Leemhuis01/AM-FM-modulator-met-ESP32/README.md

English below

verkoop/sale: https://github.com/Leemhuis01/Products
# AM/FM Modulator 
Dit zijn de bestanden die bij een AM/FM modulator van Otto Tuil horen.
Oorspronkelijk besproken in: https://www.transistorforum.nl/forum/index.php?id=77783

# AM/FM Modulator ENG
These are the files that belong to an AM/FM modulator by Otto Tuil.
Originally discussed at: https://www.transistorforum.nl/forum/index.php?id=77783
