Leemhuis01/AM-FM-modulator-met-ESP32/Onderdelen lijst AM-FM station met linkjes.xlsx

 |  |  |  |  |  |  | €57.94
Item | Qty | Reference(s) | Value | DNP | Footprint / Type
1 | 3 | C1, C40, C41 | 220 µF/25V |  | Electrolytic cap, D 8mm, pitch 3.5 mm | €2.20 | TA-P 220U 35-2: Elko, radiaal, 220 µF, 35 V, RM 3,5, 135 °C, 2000 uur, 20% bei reichelt elektronik (https://www.reichelt.nl/nl/nl/elko-radiaal-220-f-35-v-rm-3-5-135-c-2000-uur-20--ta-p-220u-35-2-p228402.html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)
2 | 2 | C2, C52 | 100n | DNP | Ceramic disc, pitch 5 mm
3 | 1 | C3 | 100p |  | Ceramic disc, pitch 2.5 mm
4 | 3 | C4, C54, C55 | 100n |  | MKT, pitch 5 mm | €10.00
5 | 2 | C5, C25 | 47p |  | Ceramic disc, pitch 2.5 mm
6 | 1 | C6 | 27p |  | Ceramic disc, pitch 2.5 mm
7 | 1 | C7 | 470n |  | MKT, pitch 5 mm
8 | 15 | C8, C9, C10, C11, C12, C13, C19, C27, C28, C29, C36, C37, C38, C39, C48 | 100n |  | Ceramic disc, pitch 5 mm
9 | 1 | C14 | 2n2 |  | MKT, pitch 5 mm
10 | 1 | C15 | 10 µF |  | Electrolytic cap, D 6.3mm, pitch 2.5 mm | €0.21 | Artikelnummer: GA-A 10U 25 (https://www.reichelt.nl/nl/nl/elko-radiaal-10-f-25-v-rm-1-5-105-c-1000-uur-20--ga-a-10u-25-p228364.html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)
11 | 1 | C16 | 10n |  | MKT, pitch 5 mm
12 | 1 | C17 | 120p |  | -
13 | 1 | C18 | 100 µF |  | Electrolytic cap, D 8mm, pitch 3.5 mm | €0.34 | Artikelnummer: GA-A 100U 16 (https://www.reichelt.nl/nl/nl/elko-radiaal-100-f-16-v-rm-2-5-105-c-1000-uur-20--ga-a-100u-16-p228361.html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)
14 | 2 | C20, C22 | 1n |  | MKT, pitch 5 mm
15 | 2 | C21, C23 | 470p |  | MKT, pitch 5 mm
16 | 1 | C24 | 10n |  | Ceramic disc, pitch 2.5 mm
17 | 3 | C26, C46, C47 | 15p |  | Ceramic disc, pitch 2.5 mm
18 | 4 | C30, C31, C32, C33 | 22n |  | MKT, pitch 5 mm
19 | 1 | C34 | 120p | DNP | -
20 | 1 | C35 | 142+59 pF |  | Variable capacitor type 223P |  | https://nl.aliexpress.com/item/32887319637.html?mp=1
21 | 1 | C42 | 1000 µF/35V |  | Electrolytic cap, D 13mm, pitch 5 mm | €0.70 | Artikelnummer: NHG-A 1,0M 35 (https://www.reichelt.nl/nl/nl/elco-radiaal-1-0-mf-35-v-105-c-nhg-a-1-0m-35-p200396.html?trstct=pos_0&nbc=1)
22 | 1 | C43 | 2200 µF/16V |  | Electrolytic cap, D 13mm, pitch 5 mm | €0.93 | NHG-A 2,2M 16: Elco radiaal, 2,2 mF, 16 V, 105°C bei reichelt elektronik (https://www.reichelt.nl/nl/nl/elco-radiaal-2-2-mf-16-v-105-c-nhg-a-2-2m-16-p200402.html?trstct=pos_0&nbc=1)
23 | 2 | C44, C45 | 4n7/Y1 |  | Ceramic disc pitch 10 mm
24 | 3 | C49, C50, C51 | 10n | DNP | Ceramic disc, pitch 2.5 mm
25 | 1 | C53 | 10u | DNP | Electrolytic cap, D 6.3mm, pitch 2.5 mm
26 | 1 | C58 | 4p7 |  | Ceramic disc, pitch 2.5 mm
27 | 2 | C59, C60 | 220p |  | Ceramic disc, pitch 2.5 mm
28 | 1 | D1 | Bridge rectifier 1A |  | DIL 4 | €0.80 | B80D DIO: Bruggelijkrichter, 160 V, 1 A bei reichelt elektronik (https://www.reichelt.nl/nl/nl/bruggelijkrichter-160-v-1-a-b80d-dio-p216814.html?&trstct=pos_2&nbc=1)
29 | 2 | D2, D3 | 1N4001 |  | - | €0.07 | 1N 4001: Gelijkrichterdiode, DO41, 50V, 1A bei reichelt elektronik (https://www.reichelt.nl/nl/nl/gelijkrichterdiode-do41-50v-1a-1n-4001-p1723.html?&trstct=pos_0&nbc=1)
30 | 2 | D4, D5 | BAT85 |  | DO-35/SOD27 | €0.08 | BAT 85: Schottky Diode, DO35, 30V, 0,2A bei reichelt elektronik (https://www.reichelt.nl/nl/nl/schottky-diode-do35-30v-0-2a-bat-85-p4857.html?search=BAT85&&r=1)
31 | 1 | E1 | ANTENNA | DNP | Telescopic antenna
32 | 4 | H1, H2, H3, H4 | MountingHole | DNP | n.a.
33 | 1 | J1 | 230V~ |  | IEC 60320 C8 AC Power Socket 2 pin PCB Mount | €3.16 | Hot Selling Elektrische Socket Iec 320 C8 Power Connector BX-180-H 2 Pin Industriële Socket Uitstekende Kwaliteit Zwart (aliexpress.com) (https://nl.aliexpress.com/item/1005002713381045.html)
34 | 1 | J2 | Conn_01x03 | DNP | PinHeader 2.54mm male | €0.25 | SL 1X36G 2,54: 36-polig Pin header, recht, RM 2,54 bei reichelt elektronik (https://www.reichelt.nl/nl/nl/36-polig-pin-header-recht-rm-2-54-sl-1x36g-2-54-p19504.html?trstct=pos_3&nbc=1)
35 | 2 | J4, J5 | Keystone 900 |  | Keystone RCA ot similar | €2.66 | 10Pcs Wit/Geel/Rood Rca Av Met De Core Socket Gat Zetel 2 Pin Pcb Solderen Audio video Jack Lotusbloemzetel AV1-8.4-3B - AliExpress (https://nl.aliexpress.com/item/32872668581.html)
36 | 3 | JP1, JP7, JP9 | SolderJumper_3_Bridged12 | DNP | -
37 | 1 | JP2 | LSEL |  | PinHeader 2.54mm male
38 | 1 | JP3 | SolderJumper_3_Bridged12 | DNP | -
39 | 4 | JP4, JP5, JP6, JP8 | SolderJumper_3_Bridged12 | DNP | -
40 | 2 | L1, L2 | 330 µH |  | Axial | €1.22 | L-XHBCC 330µ: Vaste inductie, axiaal, XHBCC, ferriet, 330 µH bei reichelt elektronik (https://www.reichelt.nl/nl/nl/vaste-inductie-axiaal-xhbcc-ferriet-330-h-l-xhbcc-330--p138551.html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)
41 | 2 | L3, L4 | 180 µH |  | Axial | €2.00 | L-09HCP 180µ: Staande inductie, 09HCP, ferriet, 180 µH bei reichelt elektronik (https://www.reichelt.nl/nl/nl/staande-inductie-09hcp-ferriet-180-h-l-09hcp-180--p138652.html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)
42 | 1 | L5 | 120nH | DNP | SMD 0805 | €0.31 | L-0805AS 120N: SMD-inductiespoel, 0805, keramiek, 120 nH bei reichelt elektronik (https://www.reichelt.nl/nl/nl/smd-inductiespoel-0805-keramiek-120-nh-l-0805as-120n-p255491.html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)
43 | 1 | M1 | ESP32-WROVER-CAM |  | Placed on 2 PinHeaders 2.54mm female 20 positions | €6.36 | 2022 Nieuwste Esp32 Cam Camera Module ESP32-WROVER Bord Met Camera Wi-Fi Bluetooth Module Voor Arduino Ide C Python Code Ov2640 - AliExpress (https://nl.aliexpress.com/item/1005006198660279.html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)
44 | 1 | M2 | µSD CARD MODULE |  | Soldered on PinHeader 2.54mm male | €2.40 | Tzt Micro Sd Opslag Uitbreidingskaart Mini Micro Sd Tf Kaart Geheugenschild Module Met Pinnen Voor Arduino - AliExpress (https://nl.aliexpress.com/item/32867572635.html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)
45 | 1 | M3 | ELECHOUSE FM TRANSMITTER V2.0 | DNP | Soldered on PinHeaders 2.54mm male | €2.35 | 5 Stks/partij KT0803 KT0803L Sop-16 Fm Stereo Lancering Chip - AliExpress (https://nl.aliexpress.com/item/32828673835.html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)
46 | 1 | M4 | OLED-27X27MM |  | Including PinHeader 2.54mm male | €2.50 | 0.96 Inch Oled Ssd1306 Wit/Blauw/Geel 128X64 Iic I2c Seriële Weergavemodule 12864 Lcd-Schermbord Voor Arduino (aliexpress.com) (https://nl.aliexpress.com/item/1005005970901119.html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)
47 | 1 | M5 | Hi-Link HLK-5M15 | DNP | -
48 | 1 | M6 | CN3903 5V/3A Module | DNP | -
49 | 3 | Q1, Q2, Q3 | 2N7000 |  | TO-92 | €0.75 | https://www.reichelt.nl/nl/nl/mosfet-n-ch-60-v-0-115-a-0-4-w-to-92-2n-7000-fai-p219076.html?trstct=pos_1&nbc=1
50 | 12 | R1, R2, R3, R4, R5, R27, R30, R39, R41, R42, R43, R44 | 10k |  | Axial 1/4 watt
51 | 1 | R6 | 100k | DNP | Axial 1/4 watt
52 | 2 | R7, R8 | 10k | DNP | Axial 1/4 watt
53 | 1 | R10 | 10R |  | Axial 1/4 watt
54 | 6 | R12, R13, R14, R15, R35, R36 | 7k5 |  | Axial 1/4 watt
55 | 4 | R16, R17, R18, R31 | 30k |  | Axial 1/4 watt
56 | 1 | R19 | 220K |  | Axial 1/4 watt
57 | 2 | R20, R21 | 1M |  | Axial 1/4 watt
58 | 1 | R22 | 2K2 |  | Axial 1/4 watt
59 | 1 | R23 | 100K |  | Axial 1/4 watt
60 | 1 | R24 | 3K3 |  | Axial 1/4 watt
61 | 1 | R25 | 2M2 |  | Axial 1/4 watt
62 | 1 | R26 | 5K6 |  | Axial 1/4 watt
63 | 3 | R28, R29, R40 | 220R |  | Axial 1/4 watt
64 | 1 | R32 | 8k2 |  | Axial 1/4 watt
65 | 2 | R33, R34 | 4K7 |  | Axial 1/4 watt
66 | 1 | R37 | 15k |  | Axial 1/4 watt
67 | 1 | R46 | 10R | DNP | Axial 1/4 watt
68 | 3 | SH1, SH2, SH3 | Shield |  | n.a. | €2.00 | Tactiele drukknopschakelaars met schakelaar 6x6x10 | 6x6x13mm tactiele drukknopschakelaar-schakelaars-Aliexpress (https://nl.aliexpress.com/item/4000275201465.html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)
69 | 1 | SW1 | DOWN |  | Tactile SPST Angled PTS645Vx83
70 | 1 | SW2 | UP |  | Tactile SPST Angled PTS645Vx83
71 | 1 | SW3 | PAUSE/OK |  | Tactile SPST Angled PTS645Vx83
72 | 1 | SW4 | MENU |  | Tactile SPST Angled PTS645Vx83
73 | 1 | SW5 | SW_SPDT |  | SWITCH C&K 7101 or similar
74 | 1 | SW7 | Rotary Encoder with Switch | DNP | -
75 | 3 | TP1, TP2, TP3 | TestPoint | DNP | n.a.
76 | 1 | TR1 | 2x7.5V/3.2VA |  | Gerth 387.15.2 | €5.70 | 387.15-2: Transformator, Gerth-serie 387.xx, 3,6VA, 2x 7,5V bei reichelt elektronik (https://www.reichelt.nl/nl/nl/transformator-gerth-serie-387-xx-3-6va-2x-7-5v-387-15-2-p2413.html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)
77 | 1 | U1 | CD4053B |  | DIP-16 | €0.50 | MOS 4053: 3X2 ANALOOG MAX bei reichelt elektronik (https://www.reichelt.nl/nl/nl/3x2-analoog-max-mos-4053-p12612.html?&trstct=pos_1&nbc=1)
78 | 1 | U2 | CD4060B |  | DIP-16 | €0.60 | MOS 4060: 14 BEST METER - DELER bei reichelt elektronik (https://www.reichelt.nl/nl/nl/14-best-meter-deler-mos-4060-p12617.html?&trstct=pos_0&nbc=1)
79 | 1 | U3 | CD4046B |  | DIP-16 | €0.71 | CD 4046BE TEX: Logic-IC DIL-16, CD4046 bei reichelt elektronik (https://www.reichelt.nl/nl/nl/logic-ic-dil-16-cd4046-cd-4046be-tex-p216649.html?&trstct=pos_0&nbc=1)
80 | 1 | U4 | CD40103B |  | DIP-16 | €0.71 | MOS 40103: 8STAND.SYN.ACHTERW.METER bei reichelt elektronik (https://www.reichelt.nl/nl/nl/8stand-syn-achterw-meter-mos-40103-p12544.html?&trstct=pos_0&nbc=1)
81 | 1 | U5 | 24LC64 |  | DIP-8 or SOIC-8 | €0.92 | 24LC64-E - P: EEPROM, serieel, 64 KB (8 k x 8 ), I2C, 2,5 ... 5,5 V, dip-8 bei reichelt elektronik (https://www.reichelt.nl/nl/nl/eeprom-serieel-64-kb-8-k-x-8-i2c-2-5--5-5-v-dip-8-24lc64-e-p-p314915.html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)
82 | 1 | U6 | PT8211 |  | SOIC-8 or DIP-8 | €2.25 | 10 Stks/partij PT8211-S PT8211 Sop-8 Op Voorraad - AliExpress (https://nl.aliexpress.com/item/33003605219.html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)
83 | 1 | U7 | 7805 |  | TO-220 with metal tab | €0.31 | µA 7805: Spanningsregelaar tot 1,5 A positief TO-220 bei reichelt elektronik (https://www.reichelt.nl/nl/nl/spanningsregelaar-tot-1-5-a-positief-to-220--a-7805-p23443.html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)
84 | 1 | U8 | 7815 |  | TO-220 with metal tab | €0.63 | MC 7815 CTG: Spanningsregelaar, 15 V,TO-220 bei reichelt elektronik (https://www.reichelt.nl/nl/nl/spanningsregelaar-15-v-to-220-mc-7815-ctg-p189086.html?trstct=pos_1&nbc=1)
85 | 1 | U9 | CD4015B |  | DIP-16 | €0.51 | CD 4015BE TEX: Logic-IC DIL-16, CD4015 bei reichelt elektronik (https://www.reichelt.nl/nl/nl/logic-ic-dil-16-cd4015-cd-4015be-tex-p216641.html?&trstct=pos_0&nbc=1)
86 | 2 | U10,U11 | LM358 |  | DIP-8 or SOIC-8 | €0.60 | LM 358 DIP: Operationele versterker, 2-voudig, DIP-8 bei reichelt elektronik (https://www.reichelt.nl/nl/nl/operationele-versterker-2-voudig-dip-8-lm-358-dip-p10483.html?trstct=pos_0&nbc=1)
87 | 1 | U12 | KT0803L |  | SOIC-16
88 | 1 | U13 | TSOP4538 | DNP | Vishay TSOP4538
89 | 1 | X1 | 9.216 MHz |  | Crystal HC49 | €0.25 | 9,2160-HC49U-S: Standaardkwarts, basistoon, 9,216000 MHz bei reichelt elektronik (https://www.reichelt.nl/nl/nl/standaardkwarts-basistoon-9-216000-mhz-9-2160-hc49u-s-p159362.html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)
90 | 1 | X2 | 32.768kHz |  | Crystal AT310 | €0.32 | IQD LFXTAL014219: Standaardkwarts, basistoon, 32.768 kHz bei reichelt elektronik (https://www.reichelt.nl/nl/nl/standaardkwarts-basistoon-32-768-khz-iqd-lfxtal014219-p245417.html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)
 |  |  |  |  | Pin header Female 2.54 mm | €2.64 | BKL 10120832: Nauwkeurige female connector 20-polig, verguld bei reichelt elektronik (https://www.reichelt.nl/nl/nl/nauwkeurige-female-connector-20-polig-verguld-bkl-10120832-p235677.html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)
